Orion-bit-dev/ESP-20-220V-Board-Design/220V-Power-Monitor-.kicad_pcb

## KiCad design 220V-Power-Monitor-.kicad_pcb (2026-11-11)

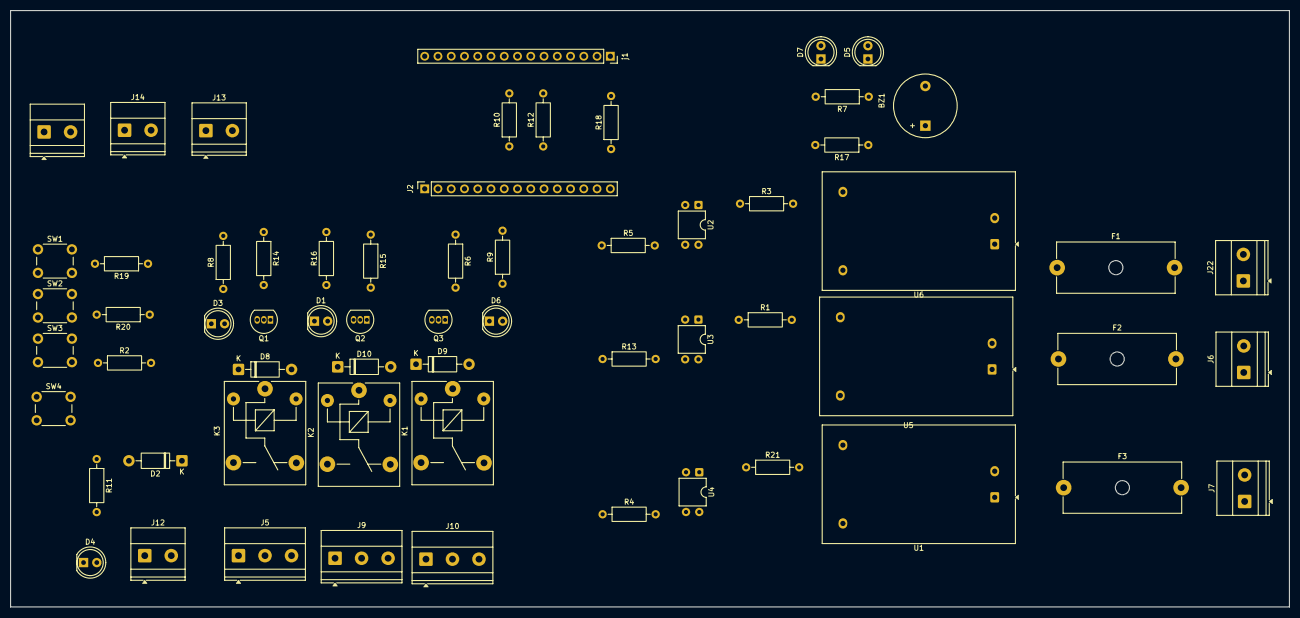
[picture p1: board 220V-Power-Monitor-.kicad_pcb from above]

Board: 2 copper layers, 245.0 x 114.2 mm, 63 parts (0 on the bottom side), 52 nets, no tracks yet.

Parts:
BZ1: Buzzer; Buzzer_12x9.5RM7.6
D1, D3, D4, D5, D6, D7: LED; LED_D5.0mm
D2, D8, D9, D10: D; D_DO-41_SOD81_P10.16mm_Horizontal
F1, F2, F3: Fuse; Fuseholder_Cylinder-5x20mm_Schurter_0031_8201_Horizontal_Op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
J2: ESP32_left_row; PinSocket_1x15_P2.54mm_Vertical
J5, J9, J10: Screw_Terminal_01x03; TerminalBlock_Phoenix_MKDS-1,5-3-5.08_1x03_P5.08mm_Horizont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
J6, J7, J8, J12, J13, J14, J22: Screw_Terminal_01x02; TerminalBlock_Phoenix_MKDS-1,5-2-5.08_1x02_P5.08mm_Horizont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
K1, K2, K3: Relay_SPDT; Relay_SPDT_SANYOU_SRD_Series_Form_C
Q1, Q2, Q3: BC337; TO-92_Inline
R1, R2, R3, R19, R20, R21: 470; R_Axial_DIN0207_L6.3mm_D2.5mm_P10.16mm_Horizontal
R4, R5, R6, R13, R14, R15: 10k; R_Axial_DIN0207_L6.3mm_D2.5mm_P10.16mm_Horizontal
R7, R8, R9, R16, R17: 330; R_Axial_DIN0207_L6.3mm_D2.5mm_P10.16mm_Horizontal
R10, R11, R12, R18: 1k; R_Axial_DIN0207_L6.3mm_D2.5mm_P10.16mm_Horizontal
SW1, SW2, SW3, SW4: SW_Push; SW_PUSH_6mm
U1, U5, U6: HLK-PM01; Converter_ACDC_Hi-Link_HLK-PMxx
U2, U3, U4: PC817; DIP-4_W7.62mm
j1: ESP32_right_row; PinSocket_1x15_P2.54mm_Vertical

Connections:
/GND_ESP: BZ1.2 (-), D1.1 (K), D3.1 (K), D4.1 (K), D5.1 (K), D6.1 (K), D7.1 (K), J2.14, J8.2, J12.2, J13.2, J14.1, Q1.3 (E), Q2.3 (E), Q3.3 (E), R6.1, R14.1, R15.1, SW1.1, SW2.1, SW3.1, SW4.1, U2.3, U3.3, U4.3, j1.2
GND_ISO1: U2.2, U6.3 (-Vout)
GND_ISO2: U3.2, U5.3 (-Vout)
GND_ISO3: U1.3 (-Vout), U4.2
unnamed: BZ1.1 (+), j1.7
unnamed: D1.2 (A), R16.1
unnamed: D2.2 (A), J12.1, R11.1
unnamed: D3.2 (A), R8.1
unnamed: D4.2 (A), R11.2
unnamed: D5.2 (A), R7.2
unnamed: D6.2 (A), R9.1
unnamed: D7.2 (A), R17.2
unnamed: D8.2 (A), Q1.1 (C)
unnamed: D9.2 (A), Q3.1 (C)
unnamed: D10.2 (A), Q2.1 (C)
unnamed: D2.1 (K), D8.1 (K), D9.1 (K), D10.1 (K), J2.15
unnamed: J2.2, R4.2, U4.4
unnamed: J2.4, R5.2, U2.4
unnamed: J2.5, R13.2, U3.4
unnamed: J2.6, SW4.2
unnamed: J2.7, R9.2
unnamed: J2.8, R19.1, SW1.2
unnamed: J2.9, R20.2, SW2.2
unnamed: J2.10, R2.1, SW3.2
unnamed: J2.11, R8.2
unnamed: J2.13, R16.2
unnamed: J6.1, U5.2 (AC/N)
unnamed: F2.1, J6.2
unnamed: J7.1, U1.2 (AC/N)
unnamed: F3.2, J7.2
unnamed: J8.1, R19.2
unnamed: J13.1, R2.2
unnamed: J14.2, R20.1
unnamed: J22.1, U6.2 (AC/N)
unnamed: F1.2, J22.2
unnamed: Q1.2 (B), R10.1, R14.2
unnamed: Q2.2 (B), R12.1, R15.2
unnamed: Q3.2 (B), R6.2, R18.1
unnamed: R1.1, U3.1
unnamed: R3.1, U2.1
unnamed: R21.1, U4.1
unnamed: R21.2, U1.4 (+Vout)
unnamed: F3.1, U1.1 (AC/L)
unnamed: R1.2, U5.4 (+Vout)
unnamed: F2.2, U5.1 (AC/L)
unnamed: R3.2, U6.4 (+Vout)
unnamed: F1.1, U6.1 (AC/L)
unnamed: R4.1, R5.1, R13.1, R17.1, j1.1
unnamed: R7.1, j1.5
unnamed: R10.2, j1.9
unnamed: R12.2, j1.10
unnamed: R18.2, j1.15
